KunVa-17/grove-gas-telemetry/docs/Grove_Gas_Sensor_STM32_ESP32_Integration_Engineering_Document.docx

Grove Multichannel Gas Sensor V2
STM32MP157-DK1 → ESP32-A → ESP32-B

Engineering Integration & Validation Document

Document status: Milestone completed / baseline validated

Scope: Grove Gas Sensor V2 acquisition on STM32MP157-DK1, UART transport using a POSIX shell script, UART reception on XIAO ESP32-C3, and ESP-NOW transport to a second XIAO ESP32-C3.

Out of scope: CRC, retries, acknowledgements, channel hopping, jamming resistance, ppm calibration, and production hardening. These are intentionally held for a later milestone.

# 1. System Overview

This milestone implements and validates a complete gas-sensor telemetry path. The Grove Multichannel Gas Sensor V2 is connected to the Linux side of the STM32MP157D-DK1 over I²C. The STM32 Linux userspace reads three required gas channels (NO₂, Ethanol and CO), packages the raw readings into a simple ASCII record, and transmits the record through UART7. ESP32-A receives the UART record and forwards the same bytes through ESP-NOW. ESP32-B receives the ESP-NOW payload, parses it, and displays the gas names and raw sensor values.

Grove Multichannel Gas Sensor V2
│
│ I²C (7-bit address 0x08)
▼
STM32MP157D-DK1 / OpenSTLinux
│
│ UART7 / /dev/ttySTM2
│ 115200 8N1
▼
XIAO ESP32-C3 (ESP32-A)
│
│ ESP-NOW
▼
XIAO ESP32-C3 (ESP32-B)
│
▼
Human-readable gas data on Serial Monitor

# 2. Hardware Used

Component | Role | Relevant details
STM32MP157D-DK1 | Linux gateway / sensor host | OpenSTLinux; I²C5 + UART7
Grove Multichannel Gas Sensor V2 | Gas sensing | Grove I²C; default 7-bit address 0x08
XIAO ESP32-C3 – ESP32-A | UART → ESP-NOW bridge | GPIO20 RX, GPIO21 TX
XIAO ESP32-C3 – ESP32-B | ESP-NOW receiver / display | Serial Monitor output

# 3. Gas Sensor Channel Mapping

Sensor element | Gas label | Command | Telemetry
GM-102B | NO₂ | 0x01 | NO2
GM-302B | Ethanol | 0x03 | Ethanol
GM-502B | VOC | 0x05 | Not transmitted
GM-702B | CO | 0x07 | CO

Only NO₂, Ethanol and CO are included in this milestone. VOC/GM-502B is intentionally excluded.

# 4. Measurement Interpretation

The transmitted values are raw sensor readings, not ppm. The Seeed module documentation describes the module as suitable for qualitative rather than quantitative measurements. A sensor-element concentration range is not, by itself, a validated raw-output-to-ppm conversion.

# 5. STM32 I²C Integration

Linux I²C5 was initially disabled in the active device tree. Only the Linux I²C5 controller node was changed from status="disabled" to status="okay". The Cortex-M4 resource node was deliberately not changed.

- status = "disabled";
+ status = "okay";

After reboot, the controller at 0x40015000 appeared as /dev/i2c-1.

i2cdetect -l

i2c-0 i2c STM32F7 I2C(0x40012000) I2C adapter
i2c-1 i2c STM32F7 I2C(0x40015000) I2C adapter
i2c-2 i2c STM32F7 I2C(0x5c002000) I2C adapter
i2c-3 i2c i2c-0-mux (chan_id 0) I2C adapter

Live pinmux:
pin 11 (PA11): device 40015000.i2c function af4 group PA11
pin 12 (PA12): device 40015000.i2c function af4 group PA12

# 6. Grove Sensor ↔ STM32 Wiring

Sensor | STM32MP157D-DK1 | Signal
SCL | CN2 pin 5 / PA11 | I²C5_SCL
SDA | CN2 pin 3 / PA12 | I²C5_SDA
VCC | 3.3 V | Power
GND | CN2 pin 6 | Ground

No solder-bridge changes were required for this direct CN2 connection. The working configuration was validated from the live device-tree/pinmux state.

# 7. Sensor Address and Protocol

The sensor was detected at the 7-bit I²C address 0x08.

i2cdetect -y 1

0 1 2 3 4 5 6 7 8 9 a b c d e f
00: 08 -- -- -- -- -- -- --

The value 0x55 encountered during investigation was not the default sensor address; it is the command used by the Seeed V2 protocol for changing the I²C address.

Read sequence:
1. Write one command byte to 0x08
2. Wait approximately 1 ms
3. Read 4 bytes
4. Interpret the four bytes as a little-endian uint32 raw value

# 8. Direct I²C Validation

i2ctransfer -y 1 w1@0x08 0x01 r4
0xe5 0x00 0x00 0x00

i2ctransfer -y 1 w1@0x08 0x03 r4
0x41 0x00 0x00 0x00

i2ctransfer -y 1 w1@0x08 0x07 r4
0x9c 0x00 0x00 0x00

These corresponded to raw values 229, 65 and 156, confirming the sensor and Linux I²C path before UART integration. Warm-up was observed during testing; readings changed during early operation and later became comparatively stable.

# 9. STM32 UART7 Configuration

UART7 is exposed by Linux as /dev/ttySTM2. PE8 is UART7_TX and PE7 is UART7_RX.

Signal | STM32 pin | DK1 connector | Connection
UART7_TX | PE8 | CN14 pin 2 | ESP32-A GPIO20 RX
UART7_RX | PE7 | CN14 pin 1 | ESP32-A GPIO21 TX
GND | GND | Board GND | Common ground

stty -F /dev/ttySTM2 115200 cs8 -cstopb -parenb -ixon -ixoff -crtscts

# 10. STM32 ↔ ESP32-A Wiring

STM32MP157-DK1 XIAO ESP32-C3 (ESP32-A)

CN14 pin 2 / PE8 / UART7_TX ------> GPIO20 / RX
CN14 pin 1 / PE7 / UART7_RX <------ GPIO21 / TX
STM32 GND -------> ESP32 GND
STM32 3V3 -------> ESP32 3V3

# 11. STM32 Gas-to-UART Bridge

A POSIX /bin/sh script was used for the prototype because i2c-tools and the UART device were already available on OpenSTLinux. The script starts sensor warming, reads NO₂/Ethanol/CO every two seconds, creates the GAS record, and writes it to /dev/ttySTM2.

#!/bin/sh

I2C_BUS=1
SENSOR_ADDR=0x08
UART_DEV=/dev/ttySTM2

stty -F "$UART_DEV" 115200 cs8 -cstopb -parenb -ixon -ixoff -crtscts

# Start sensor warming
i2cset -y "$I2C_BUS" "$SENSOR_ADDR" 0xFE

echo "Gas sensor UART bridge started."
echo "I2C bus : $I2C_BUS"
echo "Sensor : $SENSOR_ADDR"
echo "UART : $UART_DEV"

SEQ=1

read_sensor()
{
CMD="$1"
DATA=$(i2ctransfer -y "$I2C_BUS" w1@"$SENSOR_ADDR" "$CMD" r4 2>/dev/null)

if [ $? -ne 0 ] || [ -z "$DATA" ]; then
echo "ERROR: I2C read failed for command $CMD" >&2
return 1
fi

set -- $DATA
VALUE=$(( $1 | ($2 << 8) | ($3 << 16) | ($4 << 24) ))
echo "$VALUE"
}

while true
do
NO2=$(read_sensor 0x01)
ETHANOL=$(read_sensor 0x03)
CO=$(read_sensor 0x07)

if [ -n "$NO2" ] && [ -n "$ETHANOL" ] && [ -n "$CO" ]; then
MESSAGE=$(printf "GAS,%06d,%d,%d,%d" \
"$SEQ" "$NO2" "$ETHANOL" "$CO")

printf '%s\r\n' "$MESSAGE" > "$UART_DEV"
echo "STM32 TX: $MESSAGE"
SEQ=$((SEQ + 1))
else
echo "ERROR: Invalid sensor reading"
fi

sleep 2
done

# 12. Telemetry Record Format

GAS,<sequence>,<NO2_raw>,<Ethanol_raw>,<CO_raw>

Example: GAS,000006,309,64,161

Field | Meaning
GAS | Packet type / record identifier
000006 | Sequence number
309 | NO₂ raw value
64 | Ethanol raw value
161 | CO raw value

# 13. ESP32-A — UART to ESP-NOW Bridge

#include <Arduino.h>
#include <WiFi.h>
#include <esp_now.h>

HardwareSerial STM32Serial(1);

static const int STM32_RX_PIN = 20;
static const int STM32_TX_PIN = 21;

uint8_t peerAddress[] = {
0x58, 0x8C, 0x81, 0xA9, 0xE2, 0x18
};

void onDataSent(const wifi_tx_info_t *info, esp_now_send_status_t status)
{
Serial.print("ESP-NOW TX: ");
Serial.println(status == ESP_NOW_SEND_SUCCESS ? "SUCCESS" : "FAIL");
}

void setup()
{
Serial.begin(115200);
delay(1000);

Serial.println();
Serial.println("================================");
Serial.println(" STM32 UART -> ESP-NOW BRIDGE");
Serial.println("================================");

STM32Serial.begin(115200, SERIAL_8N1,
STM32_RX_PIN, STM32_TX_PIN);

Serial.println("UART configured:");
Serial.println(" Baud : 115200");
Serial.println(" RX : GPIO20");
Serial.println(" TX : GPIO21");

WiFi.mode(WIFI_STA);

Serial.print("ESP32-A MAC: ");
Serial.println(WiFi.macAddress());

if (esp_now_init() != ESP_OK)
{
Serial.println("ERROR: ESP-NOW init failed");
return;
}

esp_now_register_send_cb(onDataSent);

esp_now_peer_info_t peerInfo = {};
memcpy(peerInfo.peer_addr, peerAddress, 6);
peerInfo.channel = 0;
peerInfo.encrypt = false;

if (esp_now_add_peer(&peerInfo) != ESP_OK)
{
Serial.println("ERROR: Failed to add ESP32-B peer");
return;
}

Serial.println("ESP-NOW peer added.");
Serial.println("Waiting for STM32 UART data...");
}

void loop()
{
if (STM32Serial.available())
{
String message = STM32Serial.readStringUntil('\n');
message.trim();

if (message.length() > 0)
{
Serial.print("UART RX: ");
Serial.println(message);

esp_err_t result = esp_now_send(
peerAddress,
(uint8_t *)message.c_str(),
message.length()
);

if (result != ESP_OK)
{
Serial.print("ESP-NOW send error: ");
Serial.println(result);
}
}
}
}

# 14. ESP32-B — ESP-NOW Gas Receiver

#include <Arduino.h>
#include <WiFi.h>
#include <esp_now.h>

void onDataRecv(
const esp_now_recv_info_t *info,
const uint8_t *data,
int len
)
{
char packet[250];

if (len >= sizeof(packet))
{
Serial.println("ERROR: Packet too large");
return;
}

memcpy(packet, data, len);
packet[len] = '\0';

Serial.println();
Serial.println("================================");
Serial.println(" GAS SENSOR DATA");
Serial.println("================================");

Serial.print("Packet : ");
Serial.println(packet);

char type[10];
unsigned long sequence;
int no2;
int ethanol;
int co;

int fields = sscanf(
packet,
"%9[^,],%lu,%d,%d,%d",
type, &sequence, &no2, &ethanol, &co
);

if (fields != 5)
{
Serial.println();
Serial.println("STATUS : INVALID");
Serial.println("Reason : Invalid packet format");
Serial.println("================================");
return;
}

if (strcmp(type, "GAS") != 0)
{
Serial.println();
Serial.println("STATUS : INVALID");
Serial.println("Reason : Unknown packet type");
Serial.println("================================");
return;
}

Serial.println();
Serial.print("Sequence : ");
Serial.println(sequence);

Serial.println();

Serial.print("NO2 : ");
Serial.print(no2);
Serial.println(" RAW");

Serial.print("Ethanol : ");
Serial.print(ethanol);
Serial.println(" RAW");

Serial.print("CO : ");
Serial.print(co);
Serial.println(" RAW");

Serial.println();
Serial.println("STATUS : VALID");
Serial.println("================================");
}

void setup()
{
Serial.begin(115200);
delay(1000);

Serial.println();
Serial.println("================================");
Serial.println(" ESP-NOW GAS RECEIVER");
Serial.println("================================");

WiFi.mode(WIFI_STA);

Serial.print("ESP32-B MAC: ");
Serial.println(WiFi.macAddress());

if (esp_now_init() != ESP_OK)
{
Serial.println("ERROR: ESP-NOW initialization failed");
return;
}

esp_now_register_recv_cb(onDataRecv);

Serial.println("ESP-NOW receiver ready.");
Serial.println("Waiting for gas sensor data...");
}

void loop()
{
}

# 15. ESP-NOW Configuration

Parameter | ESP32-A | ESP32-B
Role | UART → ESP-NOW transmitter | ESP-NOW receiver
MAC | 94:A9:90:6A:22:60 | 58:8C:81:A9:E2:18
Peer channel | 0 | Current channel
Encryption | Disabled | Disabled
Arduino ESP32 core | 3.3.11 | 3.3.11

# 16. Validation Evidence

STM32 → ESP32-A UART validation:

STM32 TX: GAS,000005,219,66,162
ESP32-A: UART RX: GAS,000005,219,66,162

STM32 TX: GAS,000006,219,66,162
ESP32-A: UART RX: GAS,000006,219,66,162

ESP32-B received an intact ESP-NOW record:

22:33:29.781 -> ESP-NOW RX: GAS,000001,216,66,161

Decoded ESP32-B output:

Sequence : 5

NO2 : 310 RAW
Ethanol : 64 RAW
CO : 161 RAW

STATUS : VALID
================================

================================
GAS SENSOR DATA
================================
Packet : GAS,000006,309,64,161

Sequence : 6

NO2 : 309 RAW
Ethanol : 64 RAW
CO : 161 RAW

STATUS : VALID
================================

# 17. Milestone Result

The milestone is validated as an end-to-end raw gas telemetry pipeline.

Stage | Result
Grove Gas Sensor → STM32 I²C | PASS
STM32 sensor acquisition | PASS
STM32 UART7 → ESP32-A | PASS
ESP32-A UART reception | PASS
ESP32-A → ESP32-B ESP-NOW | PASS
ESP32-B packet parsing | PASS
Human-readable gas display | PASS

# 18. Known Limitations / Deliberate Scope

- The transmitted gas values are raw sensor values, not ppm.
- No sensor calibration curve has been established.
- VOC/GM-502B is not included in the current telemetry record.
- STATUS: VALID means the expected text structure parsed successfully; it is not a CRC or cryptographic integrity result.
- No CRC, retransmission, ACK, duplicate suppression, sequence-gap handling, channel hopping, or interference/jamming-resistance mechanism is included.
- The STM32 bridge is a prototype POSIX shell implementation.
- The sensor requires warm-up; readings changed during warm-up and later became comparatively stable.

# 19. Reproduction Procedure

1. Connect SCL→CN2 pin 5/PA11, SDA→CN2 pin 3/PA12, VCC→3.3 V, GND→CN2 pin 6.
2. Enable Linux I²C5 in the active device tree and verify /dev/i2c-1.
3. Run i2cdetect -y 1 and confirm address 0x08.
4. Verify direct reads with i2ctransfer for commands 0x01, 0x03 and 0x07.
5. Configure /dev/ttySTM2 as 115200 8N1.
6. Connect CN14 pin 2/PE8 to ESP32-A GPIO20 RX and CN14 pin 1/PE7 to GPIO21 TX; share ground.
7. Upload ESP32-A UART-to-ESP-NOW bridge.
8. Upload ESP32-B gas receiver.
9. Run /root/gas_uart_bridge.sh on STM32.
10. Verify STM32 TX, ESP32-A UART RX, and ESP32-B decoded output.

# 20. Reference Documents

STMicroelectronics UM2637, STM32MP157D-DK1 / STM32MP157F-DK2 Discovery kit user manual. The uploaded STM32MP157 device datasheet was used for the PE7/PE8 UART7 alternate-function assignment. Seeed Grove Multichannel Gas Sensor V2 documentation/source was used for the sensor command mapping, I²C address, and raw/qualitative measurement interpretation.

# 21. Final Data Path

GM-102B (NO2) ─┐
GM-302B (Ethanol) ─┼─> Sensor MCU / I²C 0x08
GM-702B (CO) ──────┘
│
▼
STM32MP157-DK1
/dev/i2c-1
│
│ POSIX sh
│ /dev/ttySTM2
▼
UART7 115200
│
▼
ESP32-A
UART -> ESP-NOW
│
▼
ESP32-B
parse + display
│
▼
NO2 : <raw>
Ethanol : <raw>
CO : <raw>
STATUS : VALID

End of milestone documentation
